calsobyte/PARALLELOGRAM-SERVO-ARM-4-SG90-MOTORS-/robotic-arm-github/robotic-arm/cad/stl/arm_assembly.stl

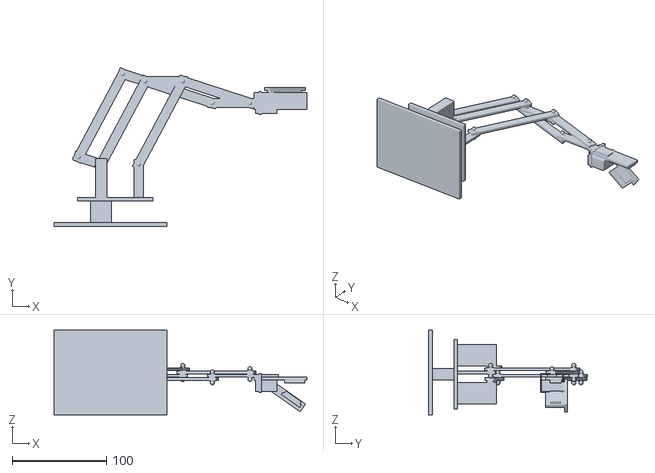
[picture p10: CAD file, 2026-11-06]
robotic-arm-github/robotic-arm/cad/stl/arm_assembly.stl
268.8 x 168.8 x 90.0
