calsobyte/PARALLELOGRAM-SERVO-ARM-4-SG90-MOTORS-/robotic-arm-github/robotic-arm/cad/stl/gripper.stl

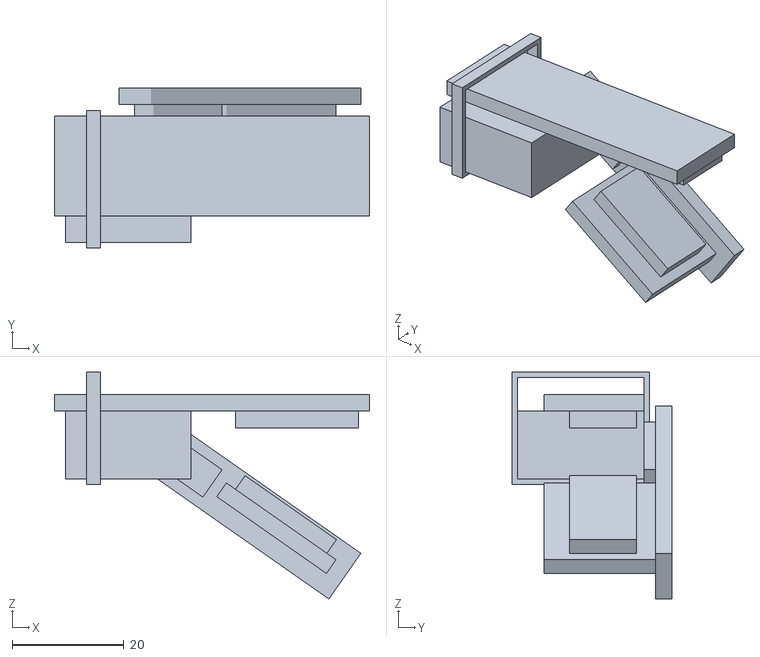
[picture p11: CAD file, 2026-11-06]
robotic-arm-github/robotic-arm/cad/stl/gripper.stl
56.5 x 28.7 x 40.7
