calsobyte/PARALLELOGRAM-SERVO-ARM-4-SG90-MOTORS-/robotic-arm-github/robotic-arm/cad/stl/layer2.stl

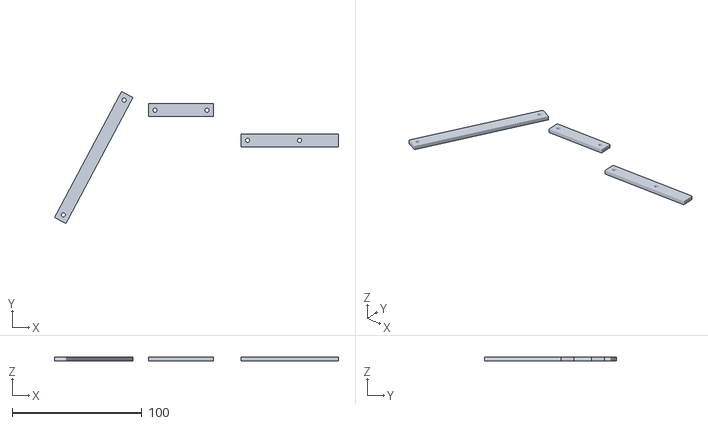
[picture p12: CAD file, 2026-11-06]
robotic-arm-github/robotic-arm/cad/stl/layer2.stl
218.8 x 101.8 x 3.00
