calsobyte/PARALLELOGRAM-SERVO-ARM-4-SG90-MOTORS-/robotic-arm-github/robotic-arm/cad/stl/layer0_front.stl

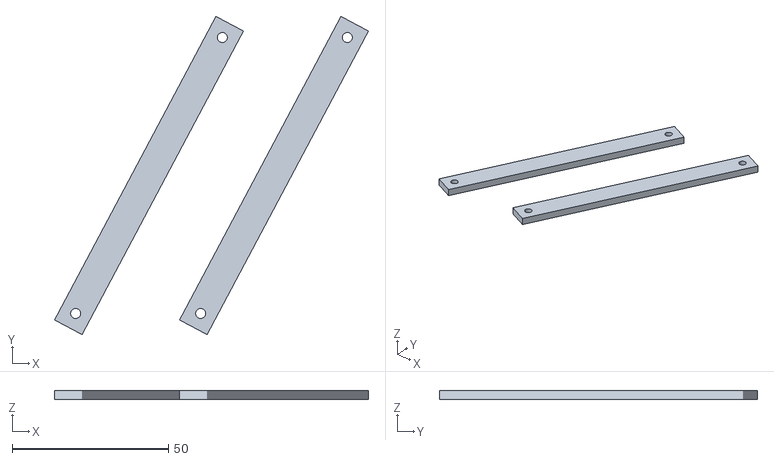
[picture p13: CAD file, 2026-11-04]
robotic-arm-github/robotic-arm/cad/stl/layer0_front.stl
100.5 x 101.8 x 3.00
