calsobyte/PARALLELOGRAM-SERVO-ARM-4-SG90-MOTORS-/robotic-arm-github/robotic-arm/cad/stl/layer1.stl

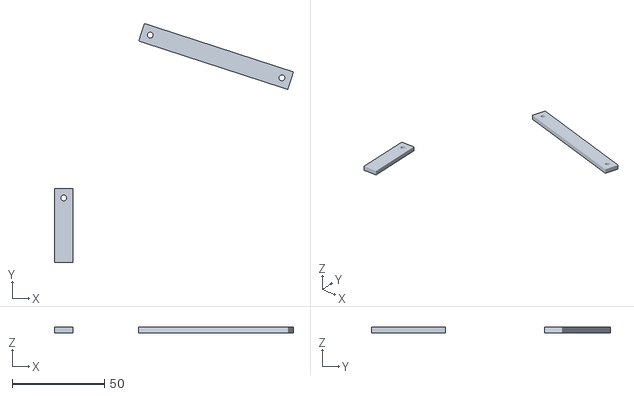
[picture p14: CAD file, 2026-11-04]
robotic-arm-github/robotic-arm/cad/stl/layer1.stl
129.6 x 129.6 x 3.00
