calsobyte/PARALLELOGRAM-SERVO-ARM-4-SG90-MOTORS-/robotic-arm-github/robotic-arm/cad/stl/base_and_servos.stl

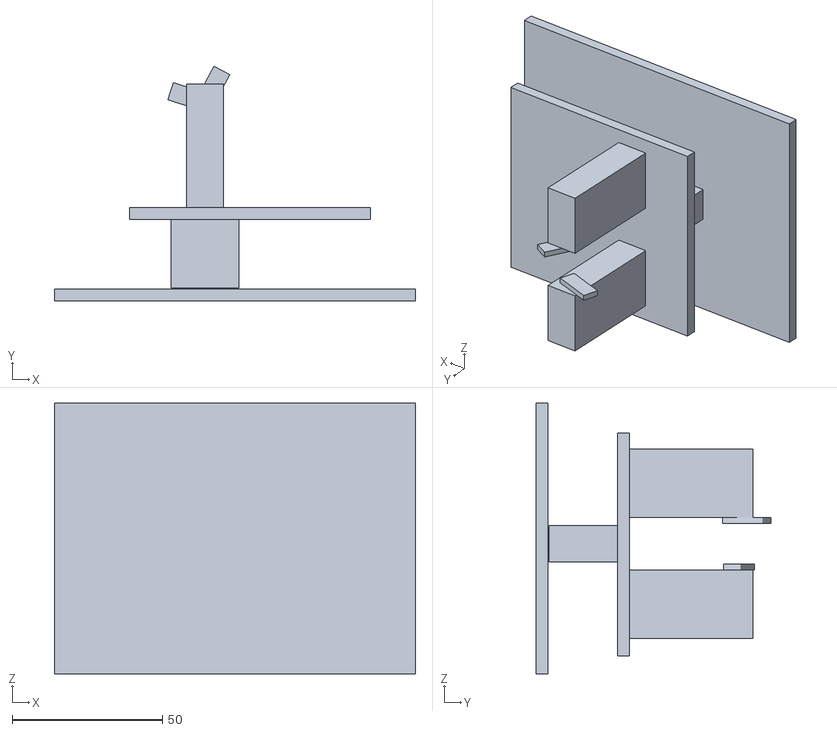
[picture p15: CAD file, 2026-11-04]
robotic-arm-github/robotic-arm/cad/stl/base_and_servos.stl
120.0 x 78.0 x 90.0
