calsobyte/PARALLELOGRAM-SERVO-ARM-4-SG90-MOTORS-/robotic-arm-github/robotic-arm/cad/stl/layer3_back.stl

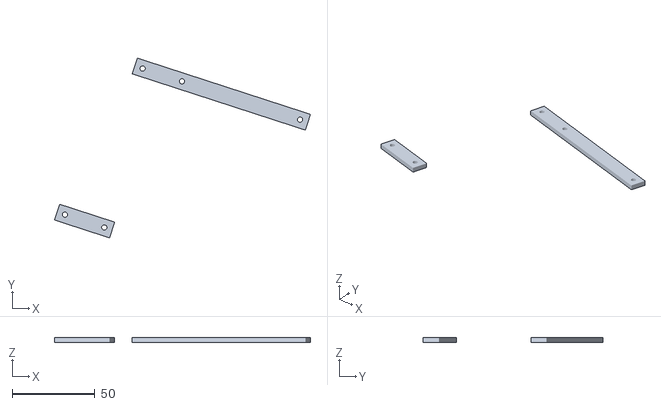
[picture p16: CAD file, 2026-11-04]
robotic-arm-github/robotic-arm/cad/stl/layer3_back.stl
154.7 x 108.6 x 3.00
