calsobyte/PARALLELOGRAM-SERVO-ARM-4-SG90-MOTORS-/robotic-arm-github/robotic-arm/cad/stl/pins_washers_glue_stops.stl

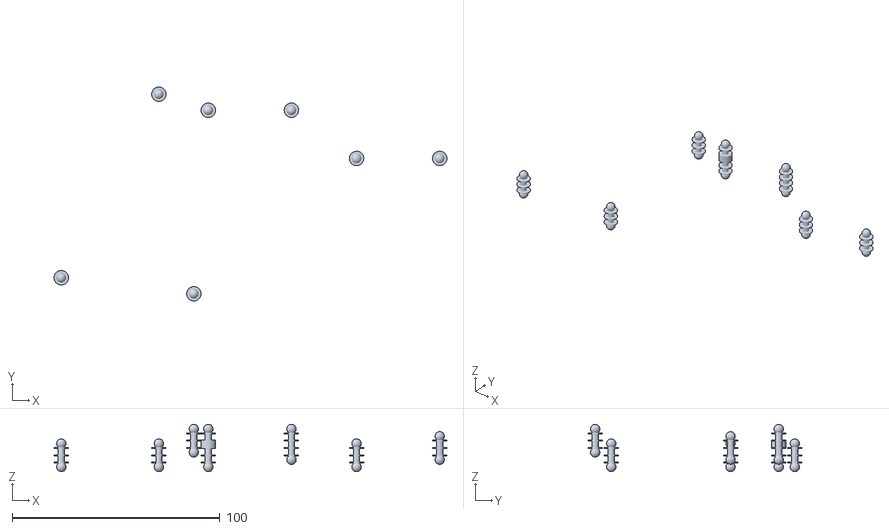
[picture p17: CAD file, 2026-11-04]
robotic-arm-github/robotic-arm/cad/stl/pins_washers_glue_stops.stl
189.1 x 103.0 x 22.8
