calsobyte/PARALLELOGRAM-SERVO-ARM-4-SG90-MOTORS-/robotic-arm-github/robotic-arm/analysis/results.txt

poses checked: 2031  (shoulder 20-100, forearm -90..20, bend 20-150 deg)

1. Same-layer sticks, closest centre-line gap (sticks are 10 mm wide, need >= 11.5 mm):
    DE - BF    12.5 mm  ( 2.5 mm between edges)  OK
    AB - KF    13.7 mm  ( 3.7 mm between edges)  OK
    BF - CH    35.0 mm  (25.0 mm between edges)  OK
    DE - CH    50.0 mm  (40.0 mm between edges)  OK
   EBC - AD    50.0 mm  (40.0 mm between edges)  OK

2. Pins passing beside other sticks, closest distance (need >= 10.0 mm):
   pin B - DE    12.5 mm  OK
   pin B - KF    13.7 mm  OK
   pin K - AB    13.7 mm  OK
   pin E - BF    25.0 mm  OK
   pin C - BF    35.0 mm  OK

3. Reach: palm end 71 to 209 mm from the axle; lowest point of the palm -41 mm below the axle

4. Gravity moment about the axle at the worst pose (shoulder/forearm (20, 0)):
   payload  0 g: 0.46 kg*cm   (half of the SG90's 1.8 kg*cm stall rating = 0.90)
   payload 10 g: 0.71 kg*cm   (half of the SG90's 1.8 kg*cm stall rating = 0.90)
   payload 15 g: 0.83 kg*cm   (half of the SG90's 1.8 kg*cm stall rating = 0.90)
   payload 20 g: 0.96 kg*cm   (half of the SG90's 1.8 kg*cm stall rating = 0.90)

5. Tilt caused by a 0.5 mm length error:
   DE (tilts the forearm)   1.1 to 3.1 deg  (median 1.3)
   KF (tilts the palm)      0.7 to 2.2 deg  (median 0.9)
   FH (tilts the palm)      0.7 to 6.3 deg  (median 1.2)
