calsobyte/PARALLELOGRAM-SERVO-ARM-4-SG90-MOTORS-/robotic-arm-github/robotic-arm/docs/photos/cut.jpg

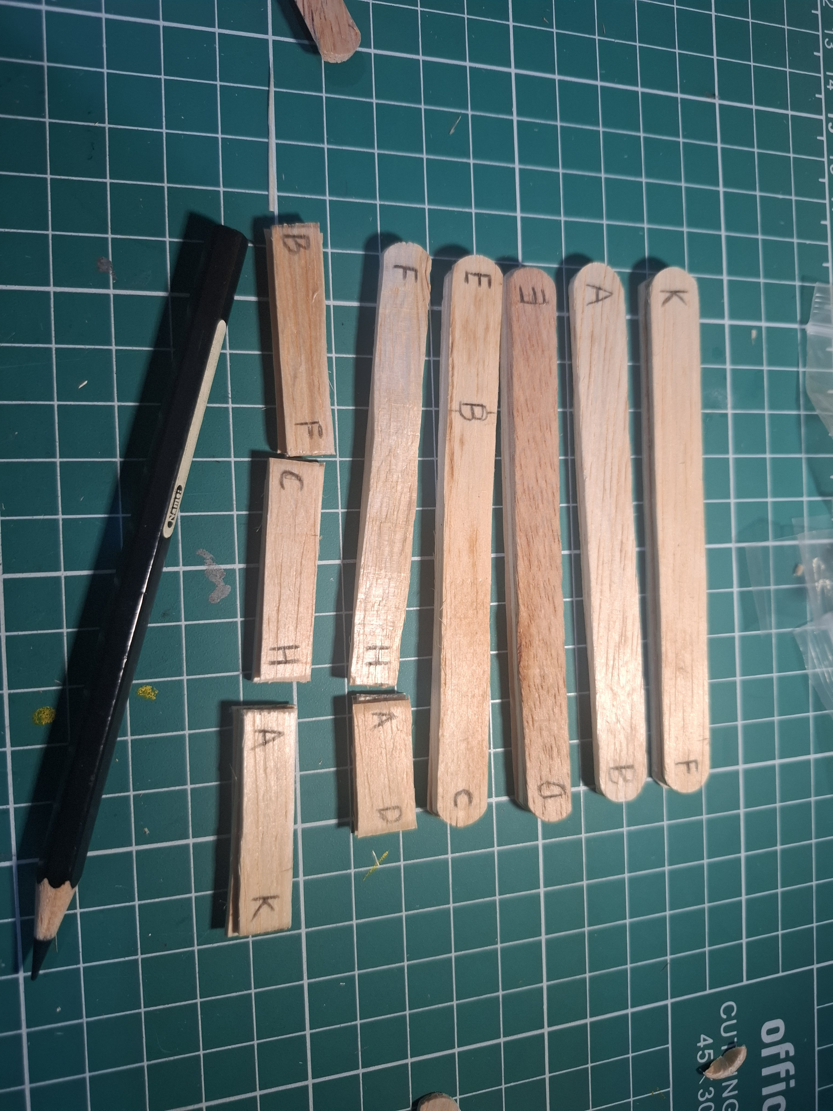
robotic-arm-github/robotic-arm/docs/photos/cut.jpg
